davidrb/opqbox2/images/capacitive-psu.png

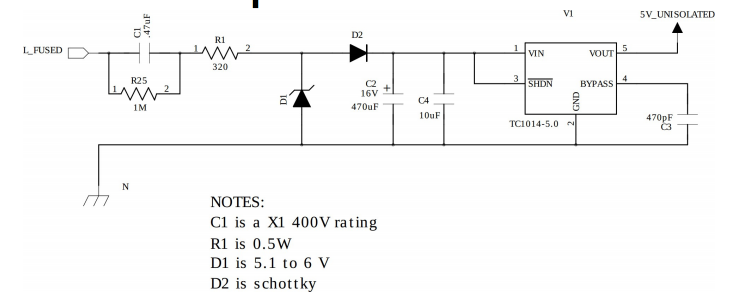
images/capacitive-psu.png
