davidrb/opqbox2/images/layout-bottom.png

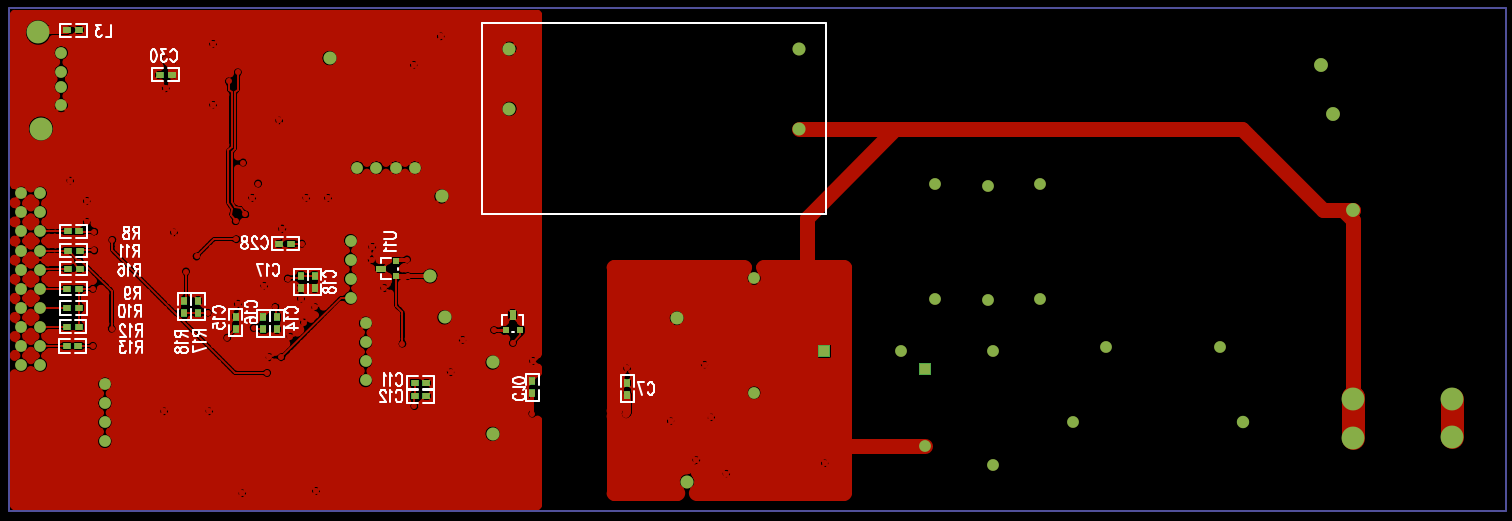
images/layout-bottom.png
