davidrb/opqbox2/images/layout-top.png

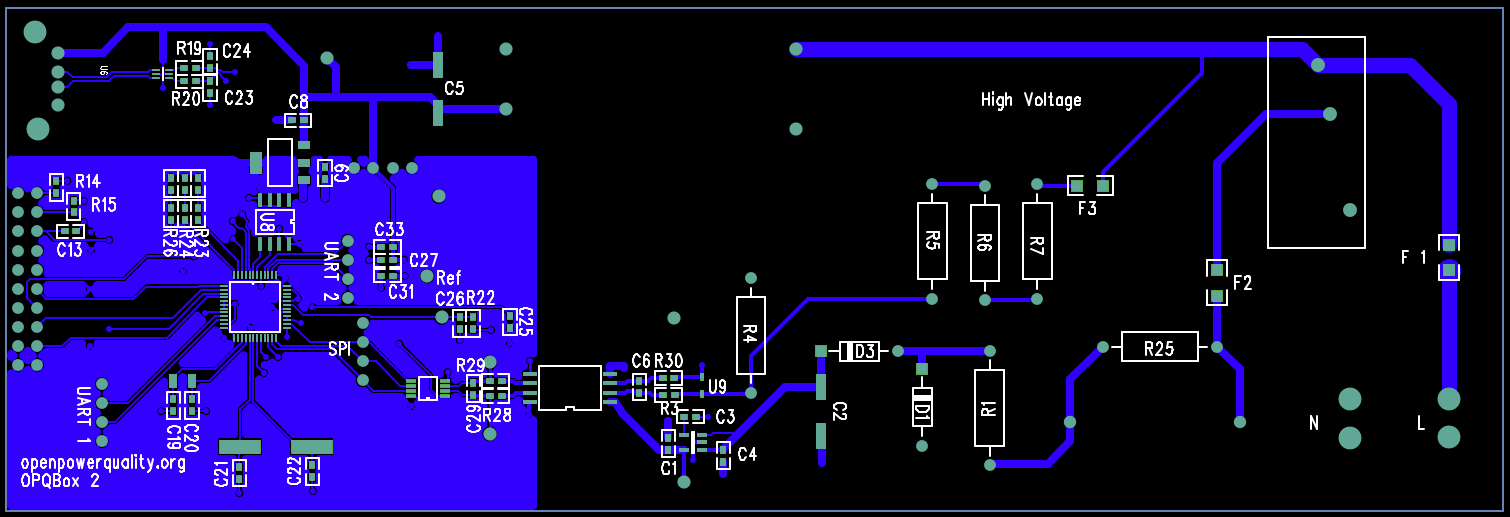
images/layout-top.png
