davidrb/opqbox2/images/layout.png

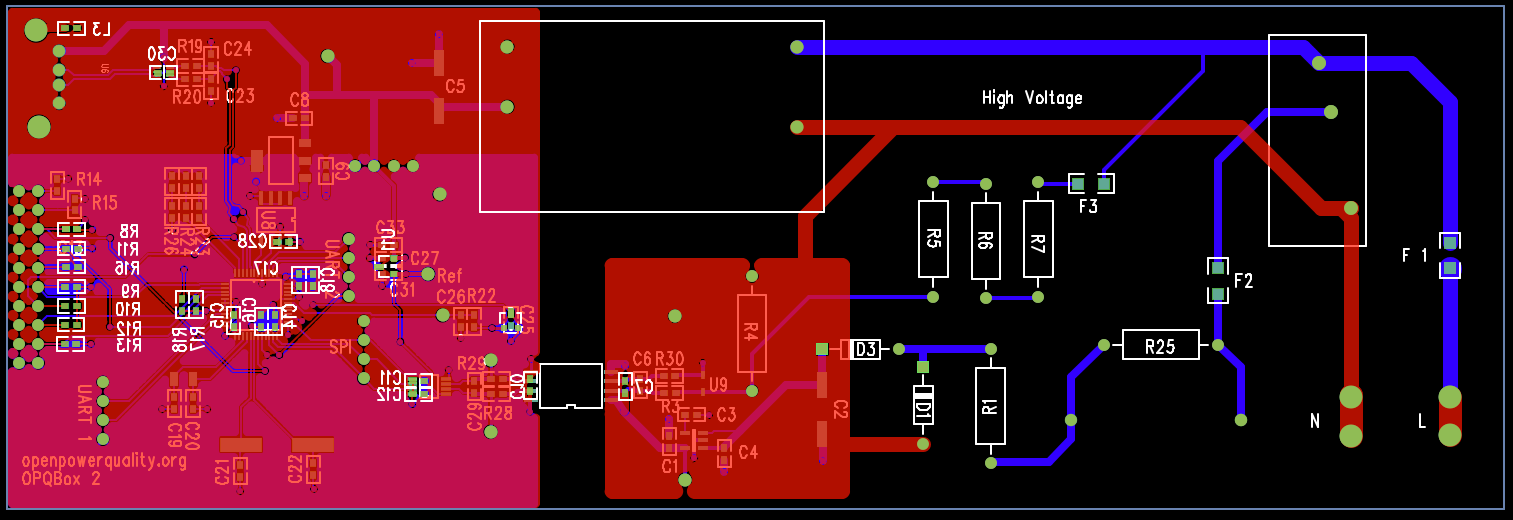
images/layout.png
