davidrb/opqbox2/images/OPQ2.6Power.png

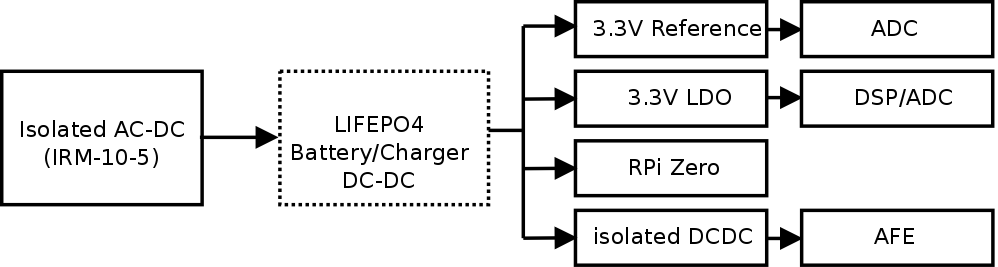
images/OPQ2.6Power.png
