davidrb/opqbox2/Mechanical/opqbox2.dxf

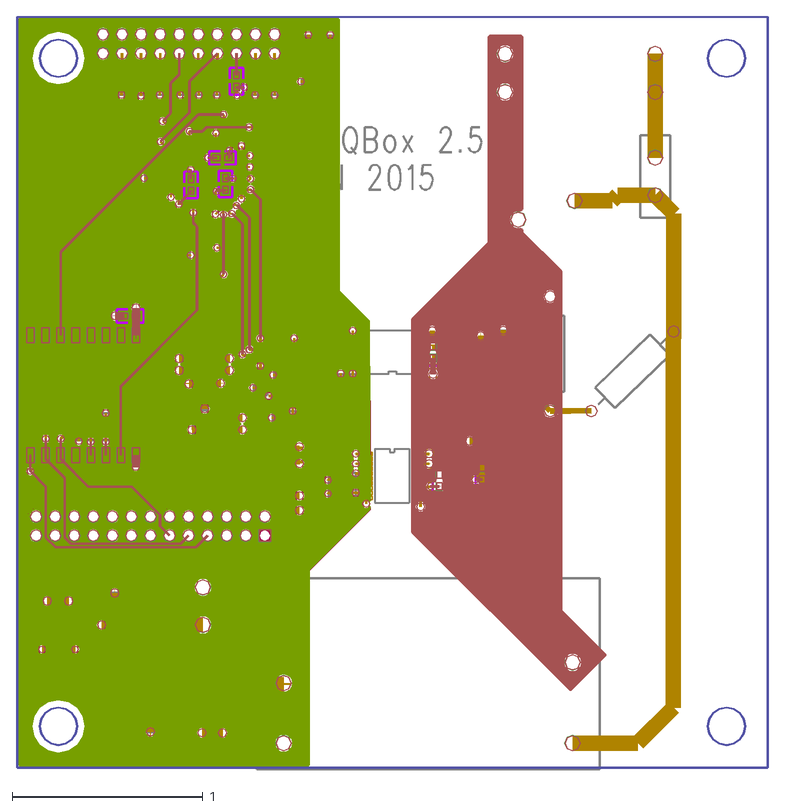
[picture p12: CAD file, 2016-01-17]
Mechanical/opqbox2.dxf
3.95 x 3.95
