davidrb/opqbox2/Schematics/opqbox2_schematic.pdf

D

6 | 5 | 4 | 3 | 2 | 1

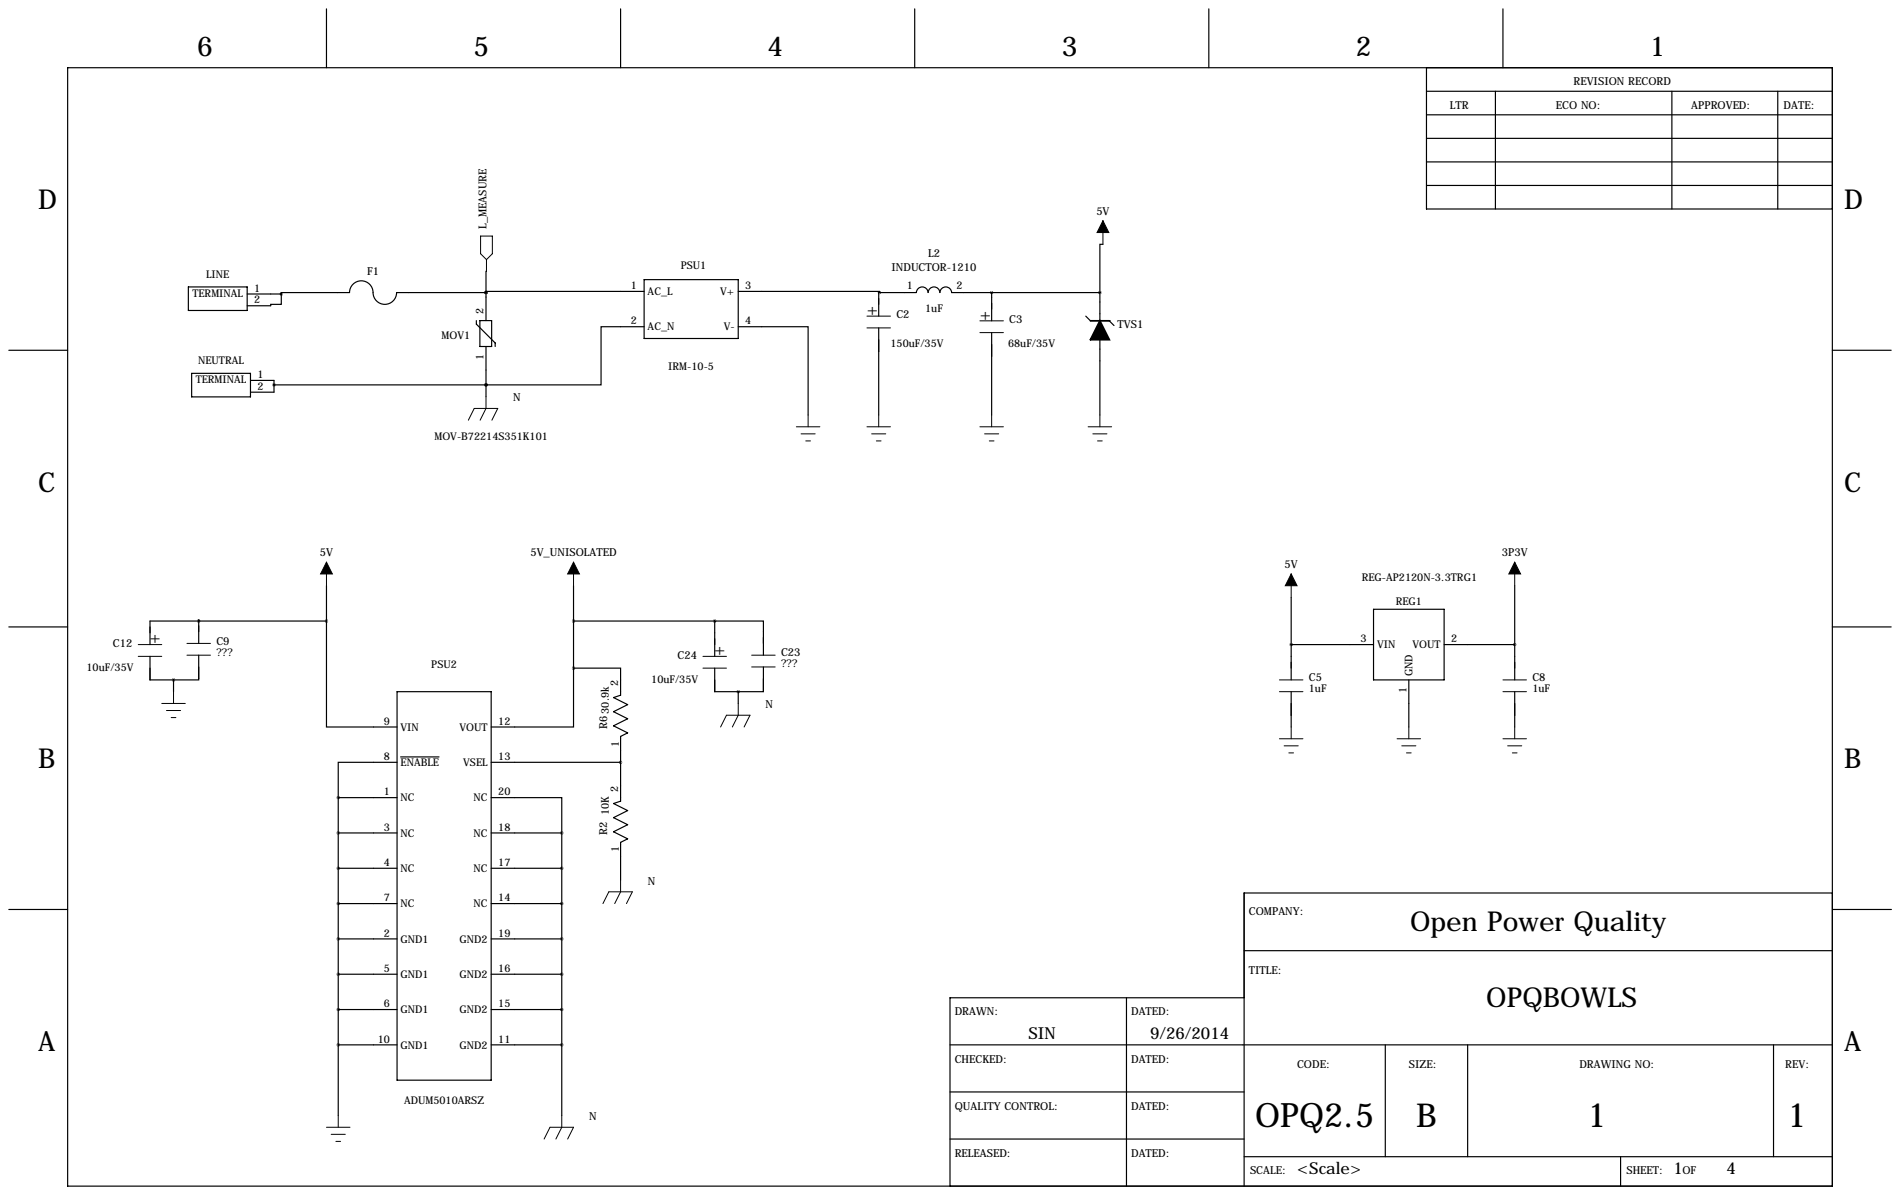
[picture p13: page 1]

REVISION RECORD

LTR | ECO NO: | APPROVED: | DATE:

2 | 19 GND2

5 | 16 GND2

6 | 15 GND2

DRAWN: SIN | DATED: 9/26/2014
CHECKED: | DATED: | CODE: OPQ2.5 | SIZE: B | DRAWING NO: 1 | REV: 1

QUALITY CONTROL: | DATED:

RELEASED: | DATED:

<Scale> SCALE: | 1 4 SHEET: OF

D

D

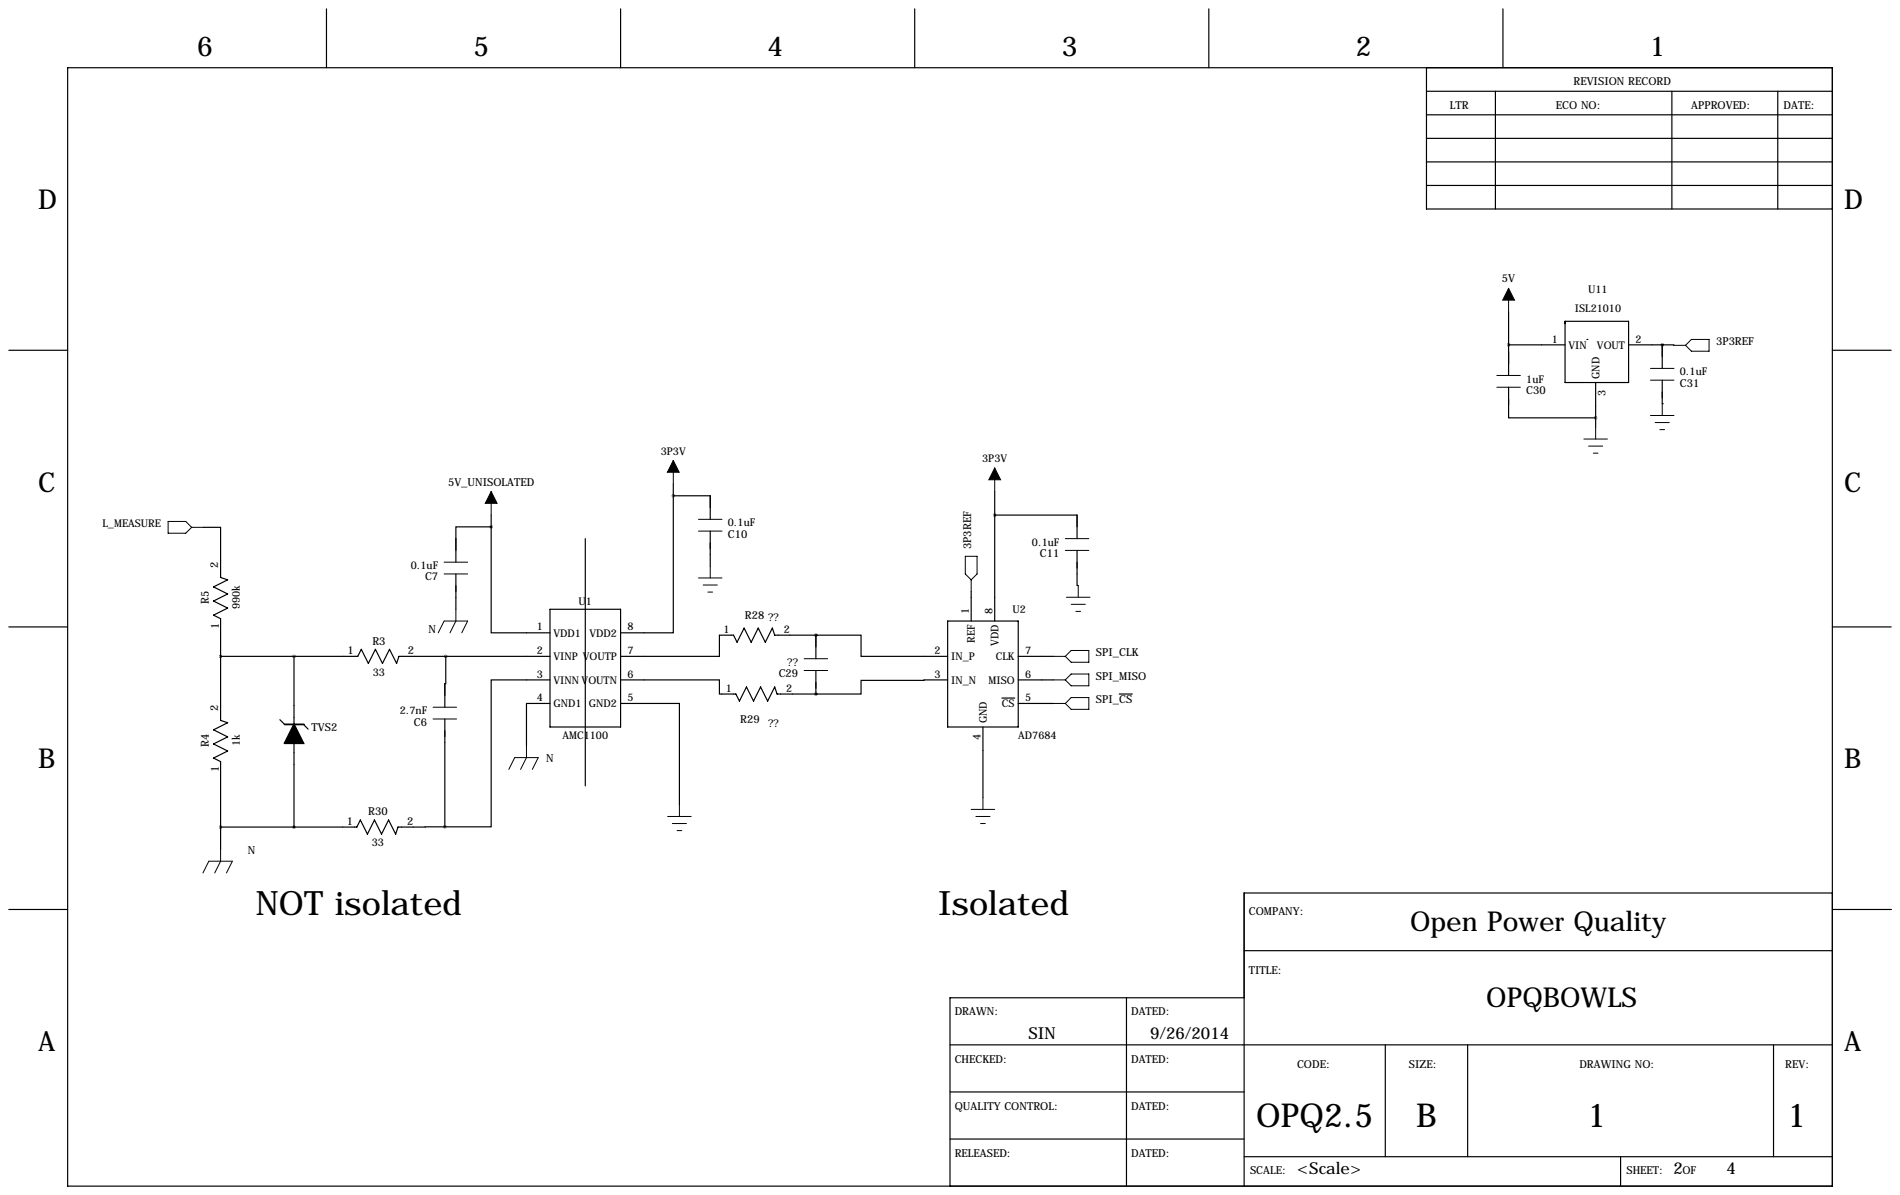
[picture p14: page 2]

REVISION RECORD

LTR | ECO NO: | APPROVED: | DATE:

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

QUALITY CONTROL: | DATED:

D

D

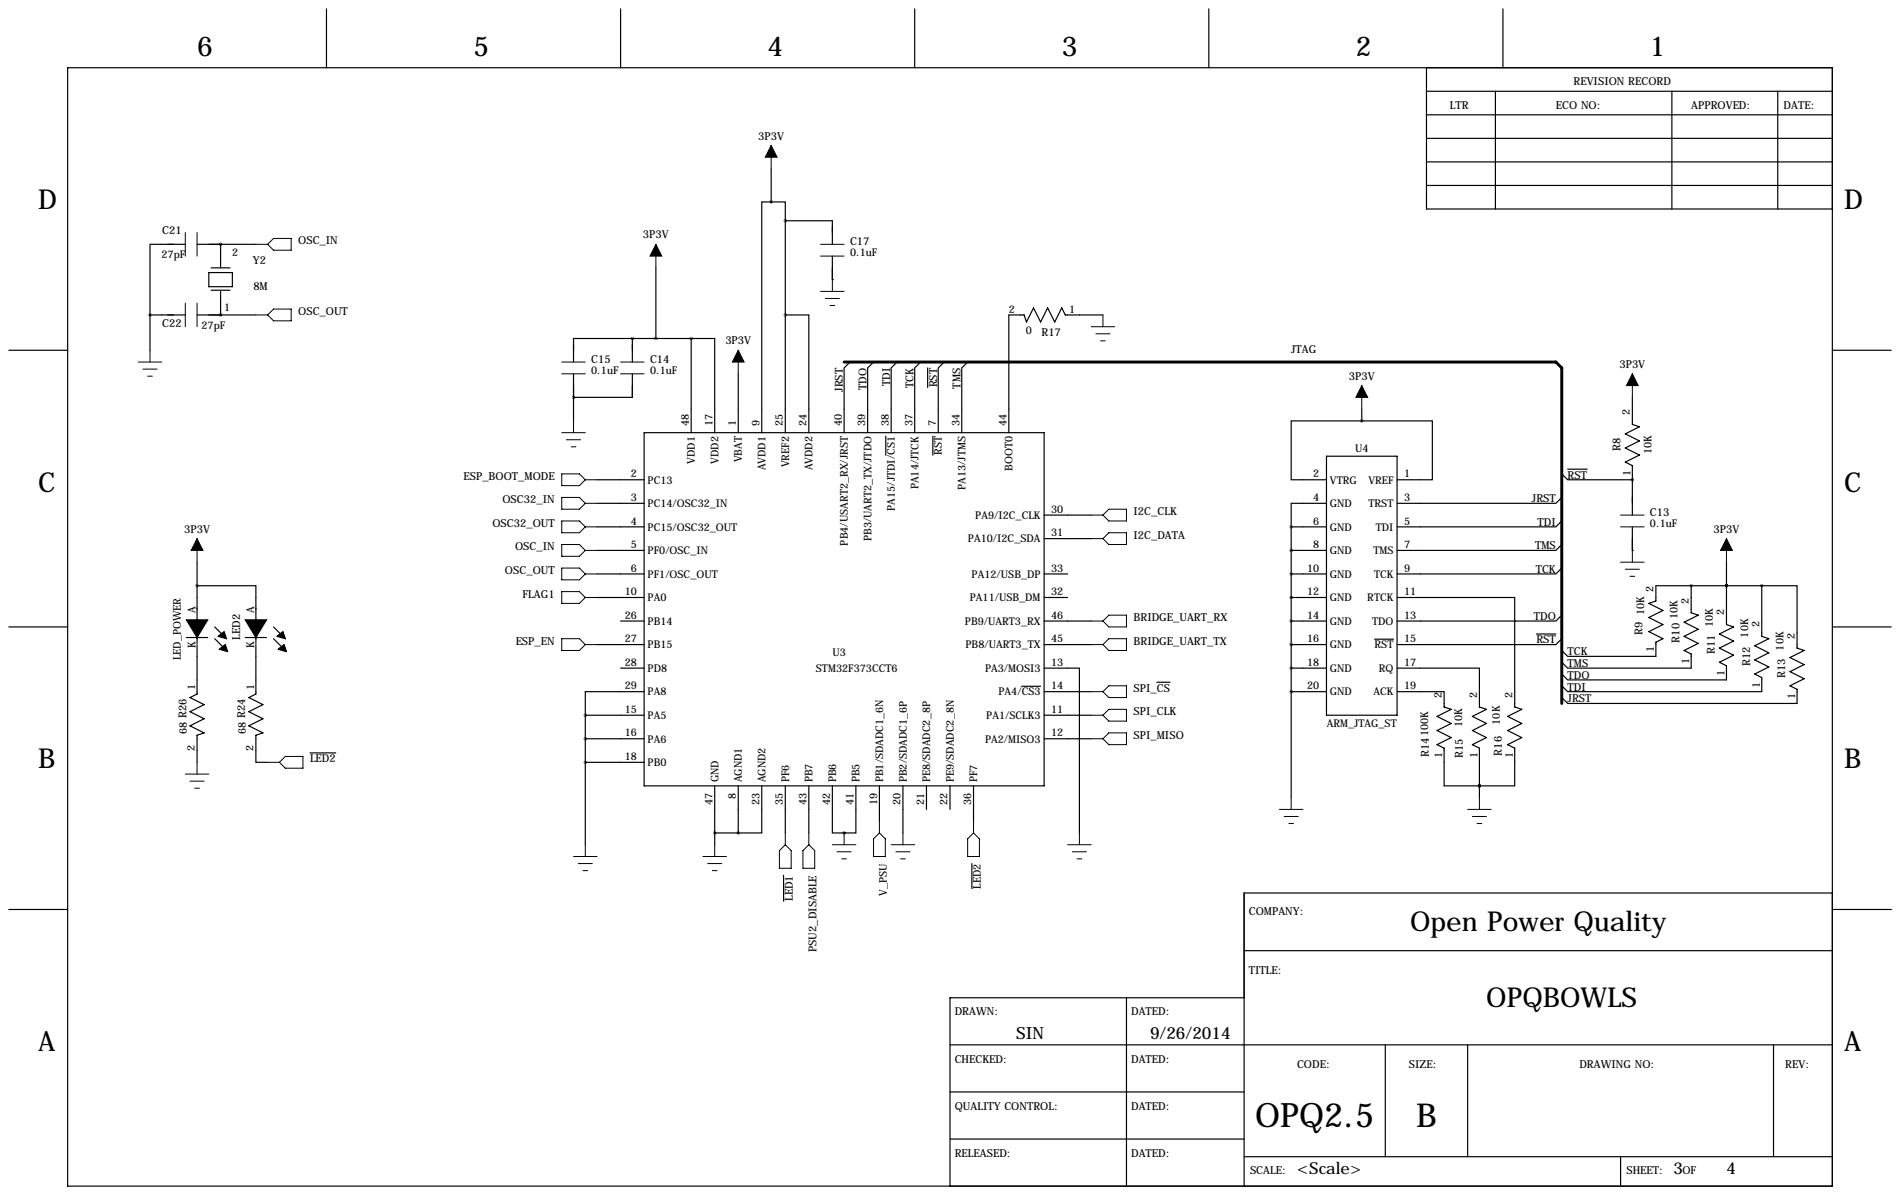
[picture p15: page 3]

0 R17 | REVISION RECORD

LTR | ECO NO: | APPROVED: | DATE:

DRAWN: SIN | DATED: 9/26/2014
CHECKED: | DATED: | CODE: OPQ2.5 | SIZE: B | DRAWING NO: | REV:

QUALITY CONTROL: | DATED:

D

D

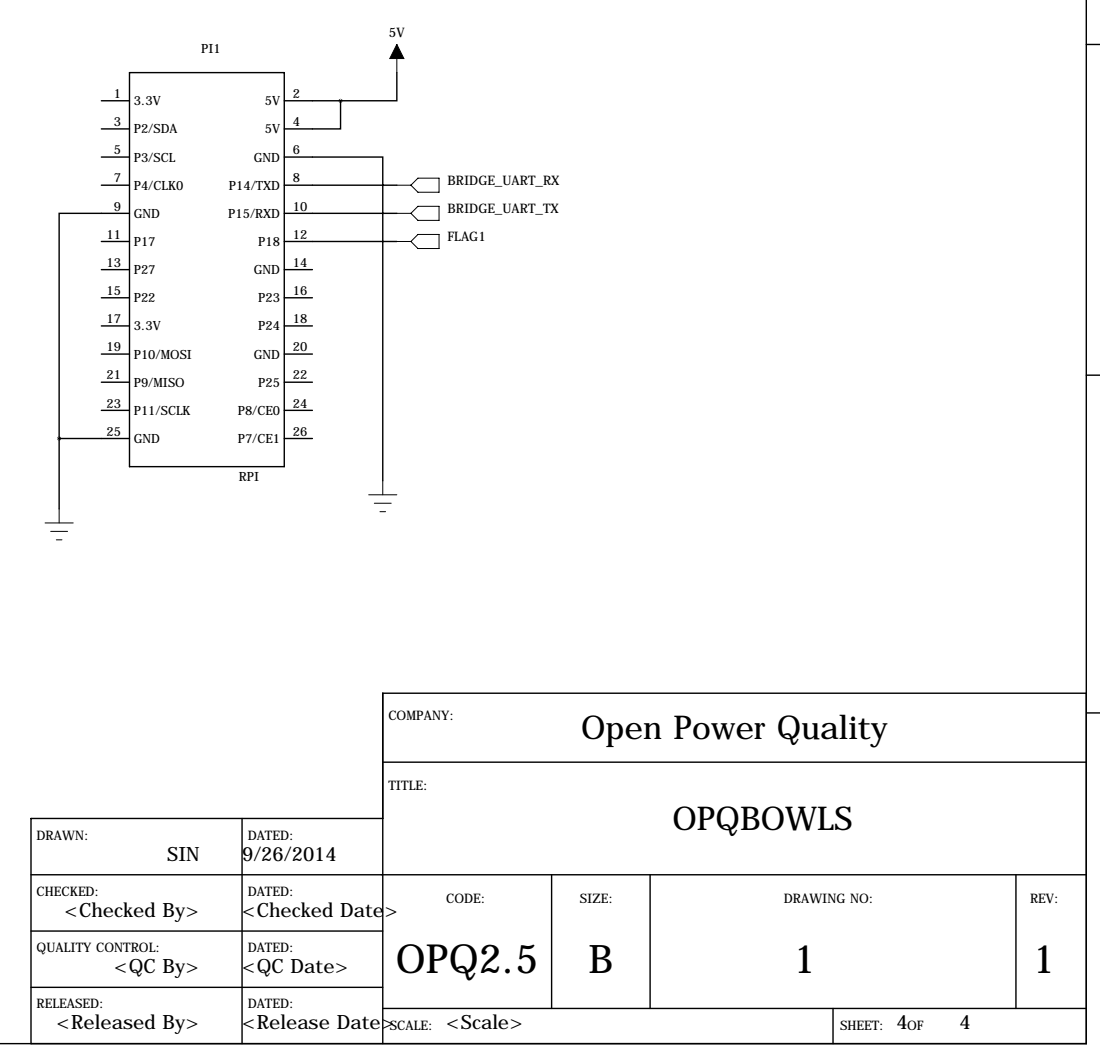
[picture p16: page 4]
<Release Date>; OPQBOWLS; COMPANY:; TITLE:; P2/SDA; P3/SCL; P4/CLK0; GND; P10/MOSI; P9/MISO; P11/SCLK; P14/TXD; 10 P15/RXD; 14 GND; 20 GND; RPI; BRIDGE_UART_RX; BRIDGE_UART_TX; FLAG1

5V | REVISION RECORD

LTR | ECO NO: | APPROVED: | DATE:

Open Power Quality

DRAWN: SIN | DATED: 9/26/2014
CHECKED: <Checked By> | DATED: <Checked Date> | CODE: OPQ2.5 | SIZE: B | DRAWING NO: 1 | REV: 1

QUALITY CONTROL: <QC By> | DATED: <QC Date>

<Released By>

<Scale> | 4 4
