davidrb/opqbox2/(list of files, drawings)

Other design files:
Schematics/opqbox2.pcb
