davidrb/opqbox2/(commit log)

2014-10-27 Cleaning Up
    Changed LICENCE to open hardware licence.
    Added BOM
    Added re-exported schematic.
    [opq2.sch]
2014-10-27 Populated Readme
    Populated the readme in the schematics and top level.
2014-10-27 Updated Readme
    A few changes:
    1. I left the provisions to install a super-cap, however FRAM IC makes dealing with power outages a lot easier. It has the same endurance and speed as regular SRAM, but retains state during power interruptions. LIPO is in no way economical, and will bump up the cost at least 20$ per unit. I think we discussed this in a meeting few months ago.
    2. Using dual transformers is how we made G1 work in the end. In G2 we forgo the transformers and work with line voltages directly, hence the need for this review.
    The rest is just tidying up.
2014-11-07 Changes from reviewers
    Betterfiltering. More circuit protection elements.
    [opq2.sch]
2014-11-14 Changes based on review
    Added a thermally fused MOV to the power input. Added a voltage
    reference for the ADC. Fused the input of the capacitive power supply
    and the measurement circuit. The thermal protection fuse is monitored,
    by powering the AMC1100 unisolated input from the fuse tap. If the input
    Added a TVC to the input of the AMC1100 to protect from ESD. Changed the
    single ended filter on the AMC1100 to a differential one. Added a
    differential filter to the adc input.
    [opq2.sch]
2014-12-11 Working through the footprints
2014-12-12 More decals
    Added more decals ~80% doen
    [opq2.sch]
2015-01-05 Continuing layout
    [opq2.sch]
2015-01-09 Finished the layout of the high voltage portion
    [opq2.sch, opqbox2.pcb]
2015-01-20 Finished Layout. Pending DFM
    [opq2.sch, opqbox2.pcb]
2015-01-27 Added the full set of gerbers. Regenerated PDFs from latest design. Generated PNGs for the readme.
    [opq2.sch, opqbox2.pcb, opqbox2.sch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]
2015-01-28 Updated the readme for the schematics folder
2015-02-18 PCB layout redone to fit the enclosure.
    [opqbox2.pcb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]
2015-07-27 Reworked power system
    Reworked power supply.
    Got rid of capacitive psu
    Got rid of temperature sensor
    Added supercap backup
    [opqbox2.sch]
2015-08-06 OPQBOX2.5
    Now with RPI header.
    [opqbox2.pcb, opqbox2.sch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]
2015-08-07 dfm fixes round one
    Working on some clearance errors
    [opqbox2.pcb, opqbox2.sch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]
2015-08-10 opqbox 2 rev C
    As submitted for manufacturing
    [opqbox2.pcb, opqbox2.sch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]
2015-09-02 Add OPQBox 2.5 sample
2015-09-09 Add engineering sample
2016-01-17 Added an image for the Power wiki page
2016-01-17 added the OPQBox2 PCB in the DXFformat
    [opqbox2.dxf]
2016-01-21 Import of the DSP code. Cleaned up the schematic PDF
2016-01-25 Added openocd scripts for flashing the ST part
    [flash.cfg, gdb.cfg]
2016-01-25 move scripts
    [flash.cfg, gdb.cfg]
2016-01-28 Added the UART example code at the end of main
    [opqbox2.sch]
